vk4kyt/LPF_Board_HF-6m_Forte600/160m-5th order filter/LPF_IMG_20230814_155846.png

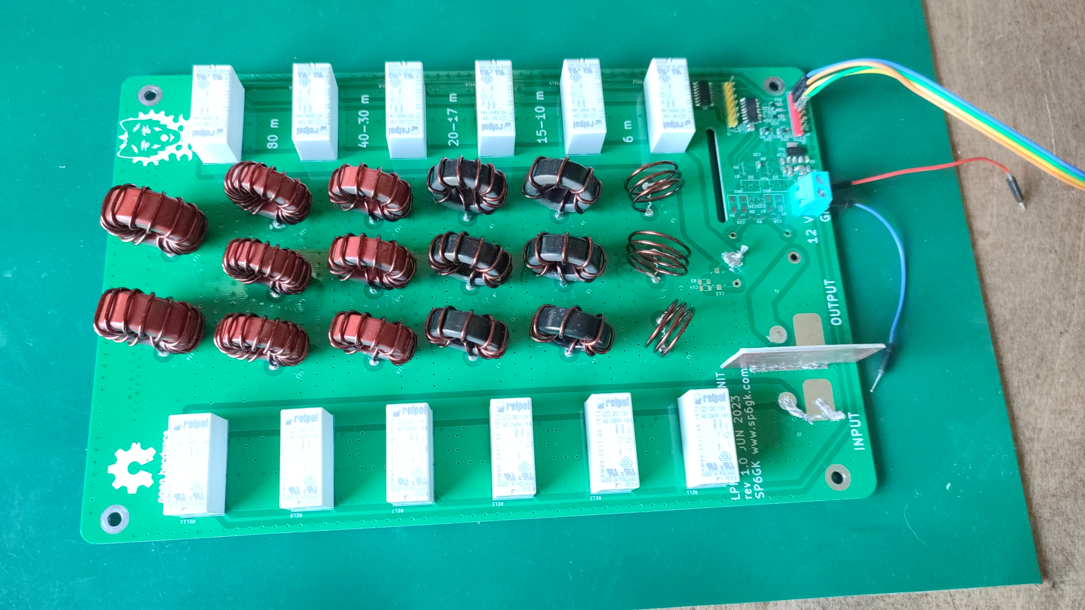
160m-5th order filter/LPF_IMG_20230814_155846.png
