vk4kyt/LPF_Board_HF-6m_Forte600/160m-5th order filter/LPF_IMG_20240224_213029.png

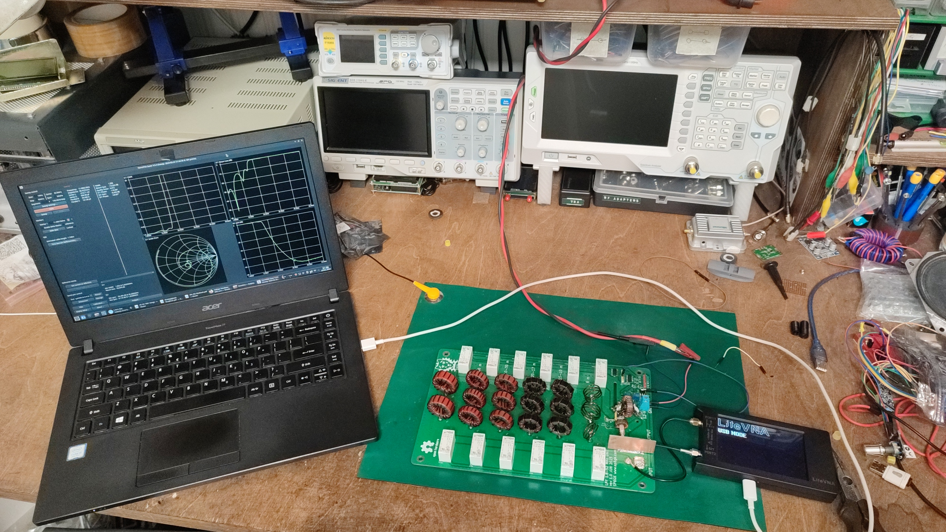
160m-5th order filter/LPF_IMG_20240224_213029.png
