vk4kyt/LPF_Board_HF-6m_Forte600/160m-5th order filter/Coilformer1y.stl

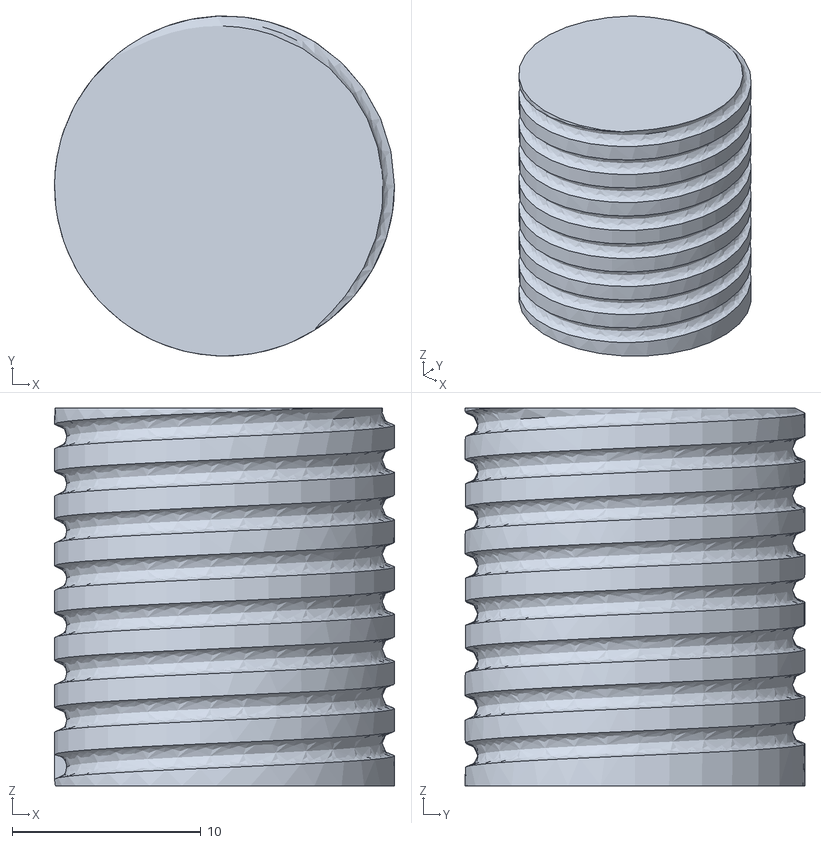
[picture p5: CAD file, 2024-10-21]
160m-5th order filter/Coilformer1y.stl
18.0 x 18.0 x 20.0
