vk4kyt/LPF_Board_HF-6m_Forte600/160m-5th order filter/Coilformer2.stl

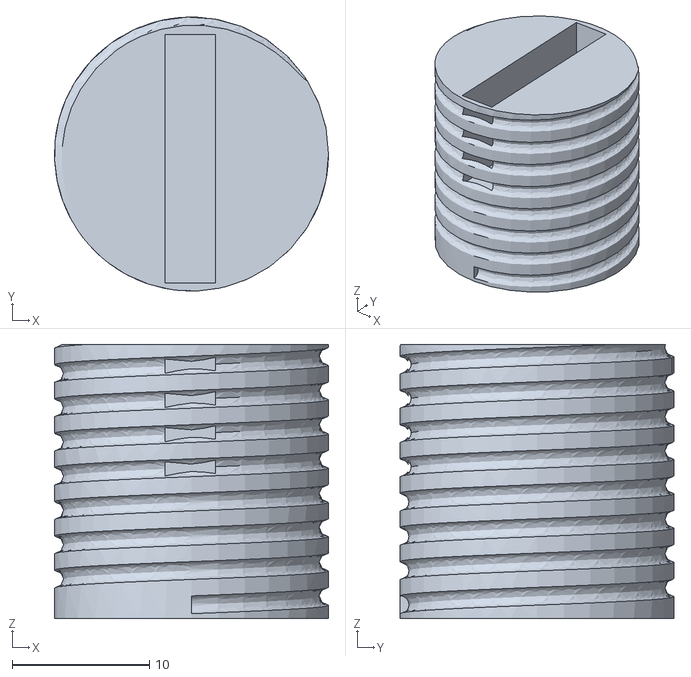
[picture p6: CAD file, 2024-10-21]
160m-5th order filter/Coilformer2.stl
20.0 x 20.0 x 20.0
