vk4kyt/LPF_Board_HF-6m_Forte600/(list of files, cad)

Other CAD files:
160m-7th order filter/Coilformer1y.SLDPRT
