vk4kyt/LPF_Board_HF-6m_Forte600/160m-5th order filter/Results/AWR_2017m2.png

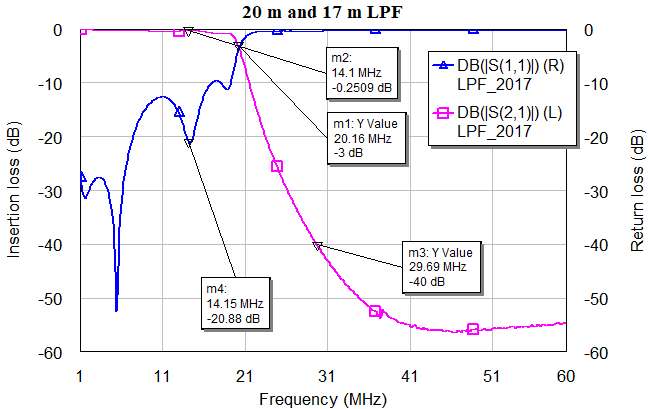
160m-5th order filter/Results/AWR_2017m2.png
