vk4kyt/LPF_Board_HF-6m_Forte600/(commit log)

2024-09-29 ERC DRC run and show no significant issues
    [LPF_HF+6.kicad_pcb, LPF_HF+6.kicad_sch]
2024-10-21 Created two sub projects
    Created two sub-projects;
    1. 160m with 5th order filter (original setup)
    2. 160m with 7th order filter ... new idea.
    [BOM_LC.ods, Coilformer1y.stl, Coilformer2.stl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]
2024-10-22 160m Cheby7
    Created and Updated 160m 7th Order Filter Design
    [LPF_HF+6.kicad_pcb, LPF_HF+6.kicad_sch]
2024-10-25 General Save
    Minor updates and improvements
    [Coilformer1y.SLDPRT, LPF_HF+6.kicad_pcb, LPF_HF+6.kicad_sch]
2024-10-27 LPF capacitor and toroid selections improved
    Added separate sheet for documenting capacitor makeup.
    reflected in BOM much more accurately.
    [Filter_Caps.kicad_sch, LPF_HF+6.kicad_pcb, LPF_HF+6.kicad_sch]
